cybertom24/eeprom_programmer/README.md

# eeprom_programmer
A repository to build a programmer for eeprom based ion arduino nano
