cybertom24/eeprom_programmer/EEPROM_PROGRAMMER/eeprom_programmer.brd

## EAGLE design EEPROM_PROGRAMMER/eeprom_programmer.brd (2023-07-19)

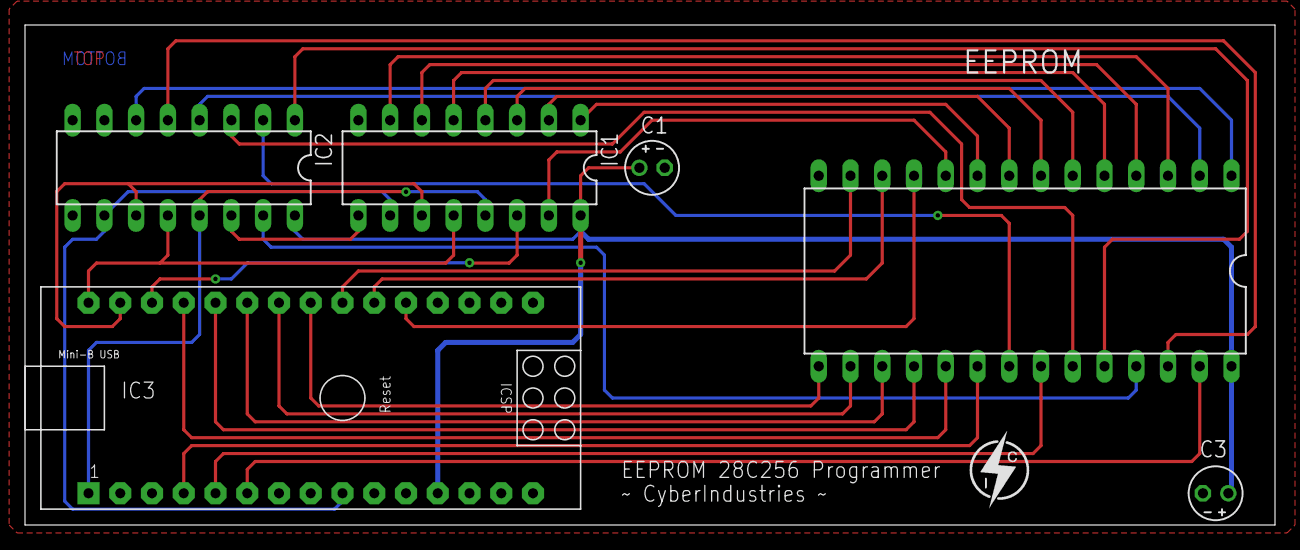
[picture p1: board eeprom_programmer.brd from above]

Board: 2 copper layers, 100.0 x 40.0 mm, 7 parts (0 on the bottom side), 34 nets.

Parts:
C1, C3: 1uF; E2-4
EEPROM: AT28C256-28DIP; DIL28-6
IC1, IC2: 74HC595N; DIL16
IC3: ARDUINO_NANO
U$1: LOGO-CYBERINDUSTRIES"; LOGO-SMALL

Connections:
A0: EEPROM.10, IC1.15
A1: EEPROM.9, IC1.1
A2: EEPROM.8, IC1.2
A3: EEPROM.7, IC1.3
A4: EEPROM.6, IC1.4
A5: EEPROM.5, IC1.5
A6: EEPROM.4, IC1.6
A7: EEPROM.3, IC1.7
A8: EEPROM.25, IC2.15
A9: EEPROM.24, IC2.1
A10: EEPROM.21, IC2.2
A11: EEPROM.23, IC2.3
A12: EEPROM.2, IC2.4
A13: EEPROM.26, IC2.5
A14: EEPROM.1, IC2.6
CE: EEPROM.20, IC3.4
G: IC1.13, IC2.13, IC3.1
GND: C1.-, C3.-, EEPROM.14, IC1.8, IC2.8, IC3.14, IC3.19
IO0: EEPROM.11, IC3.20
IO1: EEPROM.12, IC3.21
IO2: EEPROM.13, IC3.22
IO3: EEPROM.15, IC3.23
IO4: EEPROM.16, IC3.24
IO5: EEPROM.17, IC3.25
IO6: EEPROM.18, IC3.26
IO7: EEPROM.19, IC3.27
unnamed: IC1.9, IC2.14
OE: EEPROM.22, IC3.5
RCK: IC1.12, IC2.12, IC3.30
SCK: IC1.11, IC2.11, IC3.29
SCL: IC1.10, IC2.10, IC3.9
SER: IC1.14, IC3.28
VCC: C1.+, C3.+, EEPROM.28, IC1.16, IC2.16, IC3.12
WE: EEPROM.27, IC3.6
