cybertom24/eeprom_programmer/Arduino_reader/Arduino_reader.ino

/*
   Based on the TMS 2732A-45 EPROM
   Datasheet at: https://www.dexsilicium.com/tms2732a45.pdf

   EPROM pins:
   A0 ... A11: address
   Q1 ... Q8: output
   E: chip eneable (active low)
   G/Vpp: output enable (active low)

   Ta(A): Access time from address = 450ns
   Ta(E): Access time from E = 450ns
   Ten(G): Output enable time from G = 150ns
   Tdis: Output diasble time from E or G = 130ns

   Instructions:
   Vcc (24) to +5V
   GND (12) to GND
   E to LOW (= GND) (it's active low)
   G to HIGH (= Vcc)
   Cycle:
      setup the address (on pin A0 ... A11 put the desired address)
      G to LOW
      wait Ta(E) and Ta(A)
      read the output
      G to HIGH
      wait Tdis


   Designing choiches:
   Arduino NANO (328P) has 12 usable digital IO pins (D2 ... D13) and 8 analog IO pins (A0 ... A7)
   To make the things simple the 8 analog pins are assigned to the output pins of the EPROM
   with A0(arduino) to Q1 and A7(arduino) to Q8. The rest of the pins will be in order
   The first 11 digital pins are wired to the 11 address pins of the EPROM (A11 of the EPROM will be hardwired to GND) with D2 to A0(eprom) and D12 to A10(eprom).
   The rest of the pins will be in order
   D13 is connected to G
   D0 and D1 remain dedicated to the Serial
*/

#define COMMAND_START 0x69
#define COMMAND_STOP 0x96

#define s_TITLE "--- Arduino NANO based TMS 2732A-45 EPROM reader ---"
#define s_INIT1 "[!] Initializing pins..."
#define s_INIT2 "[!] Setting up pins' statuses..."
#define s_START "[!] Begin reading..."
#define s_END "[!] Reading finished"
#define s_HEX_PREFIX "0x"

#define BAUD_RATE 74880
#define ADDRESS_BITS 11
#define DATA_BITS 8
#define DELAY 10
#define READ_UNTIL pow(2, ADDRESS_BITS)
#define NEWLINE_EVERY 16

const int ADDRESS_PINS[] = { 2, 3, 4, 5, 6, 7, 8, 9, 10, 11, 12};
const int DATA_PINS[] = { A0, A1, A2, A3, A4, A5, A6, A7};
const int G_PIN = 13;

int address = 0;
byte count = 0;

boolean going = false;

void setup() {
  Serial.begin(BAUD_RATE);
  //  Serial.println(s_TITLE);
  //  Serial.println(s_INIT1);

  for (int i = 0; i < ADDRESS_BITS; i++)
    pinMode(ADDRESS_PINS[i], OUTPUT);
  for (int i = 0; i < DATA_BITS; i++)
    pinMode(DATA_PINS[i], INPUT);
  pinMode(G_PIN, OUTPUT);

  //Serial.println(s_INIT2);
  for (int i = 0; i < ADDRESS_BITS; i++)
    digitalWrite(ADDRESS_PINS[i], LOW);
  digitalWrite(G_PIN, HIGH);

  //  Serial.println(s_START);
  //  Serial.print(s_HEX_PREFIX);
  //  Serial.print(address, HEX);
  //  Serial.print(": ");
}

void loop() {
  if (Serial.available()) {
    switch (Serial.read()) {
      case COMMAND_START:
        going = true;
        address = 0;
        break;
      case COMMAND_STOP:
        going = false;
        break;
    }
  }

  if (going) {
    setupAddress(address);
    digitalWrite(G_PIN, LOW);
    wait();
    byte data = readData();
    Serial.write(data);
    //Serial.print(" ");

    setupAddress(0);
    digitalWrite(G_PIN, HIGH);
    wait();

    address++;
    if (address >= READ_UNTIL)
      going = false;
  }
  
  //  count++;
  //  if(count >= NEWLINE_EVERY) {
  //    count = 0;
  //    Serial.print("\n");
  //    Serial.print(s_HEX_PREFIX);
  //    Serial.print(address, HEX);
  //    Serial.print(": ");
  //  }
}

void setupAddress(int addr) {
  for (byte i = 0; i < ADDRESS_BITS; i++) {
    int pin = ADDRESS_PINS[i];
    int mask = 1 << i;
    boolean status = (addr & mask) != 0;

    digitalWrite(pin, status);
  }
}

byte readData() {
  byte data = 0;

  for (byte i = 0; i < DATA_BITS; i++) {
    int pin = DATA_PINS[i];
    int mask = 1 << i;

    if (pin == A6 || pin == A7) {
      if (analogRead(pin) > 128)
        data += mask;
    }
    else {
      if (digitalRead(pin))
        data += mask;
    }
  }

  return data;
}

void wait() {
  delayMicroseconds(DELAY);
}

void stop() {
  Serial.print("\n");
  Serial.println(s_END);
  while (1);
}
