cybertom24/eeprom_programmer/(commit log)

2022-07-03 initiate repo
    [eeprom_programmer.sch]
2022-09-09 tried to fix issues, nothing worked
    [Arduino_test.ino, Arduino_test.ino.cpp, ExternalEEPROM.cpp, ExternalEEPROM.h, ctags_target_for_gcc_minus_e.cpp]
2023-04-05 sistemato pcb
    [eeprom_programmer.brd]
2023-07-19 Aggiornata un po' di roba
    [eeprom_programmer.brd]
